szapata8/Ball_beam_control/Deliverables/Project Report - Draft/hardware1.jpg

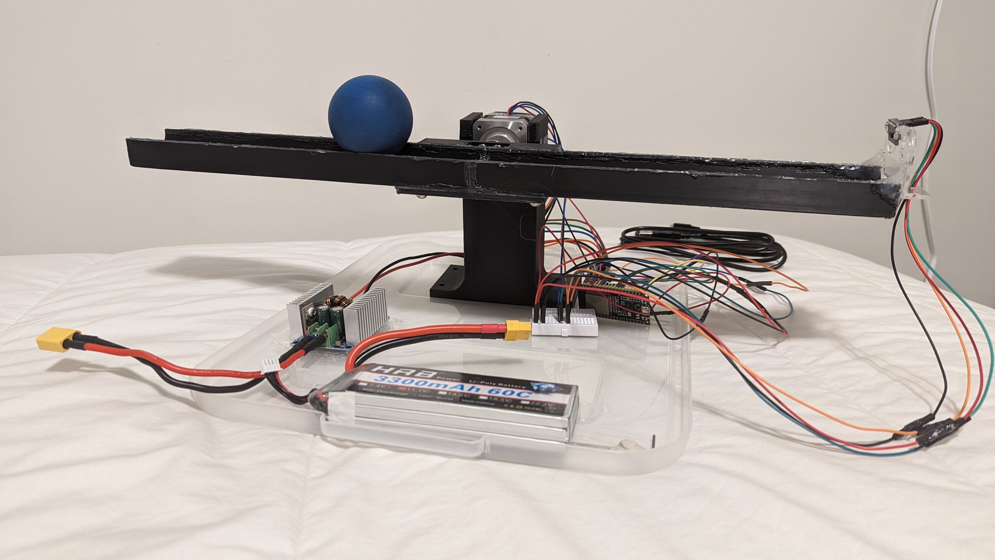
Deliverables/Project Report - Draft/hardware1.jpg
