szapata8/Ball_beam_control/Deliverables/Project Report - Draft/hardware realization.JPG

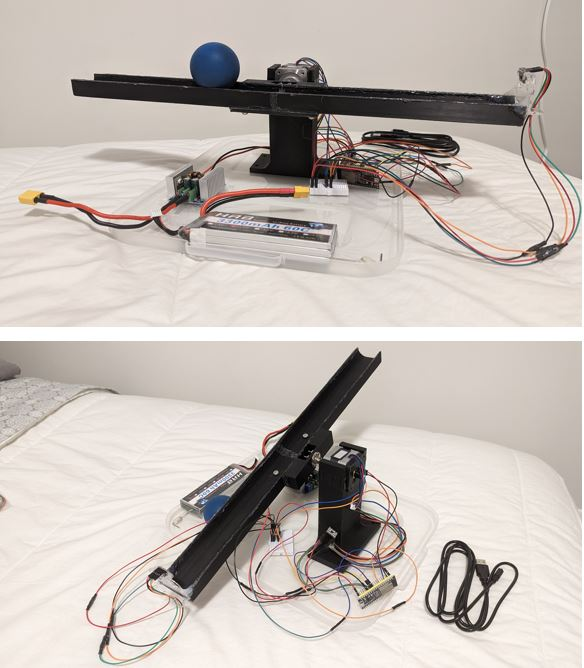
Deliverables/Project Report - Draft/hardware realization.JPG
