szapata8/Ball_beam_control/Deliverables/Project Report - Draft/Ssytem Diagram.pptx

Stepper Motor

Power System

Microcontroller
(ESP32)

Digital Pins

Stepper Motor Driver

Magnetic Encoder

Distance Sensor

Power connections

Web App
(Flask Server)

USB Serial

I2C

I2C

## Slide 2

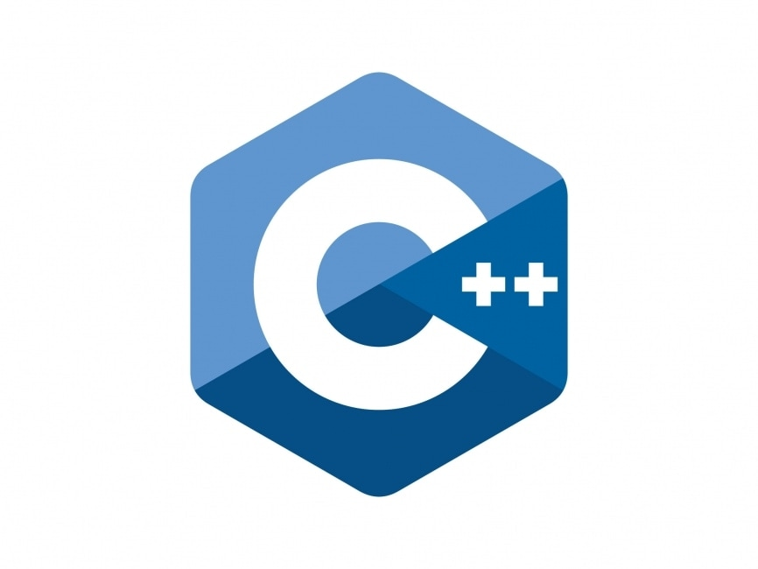
[picture p10: figure]
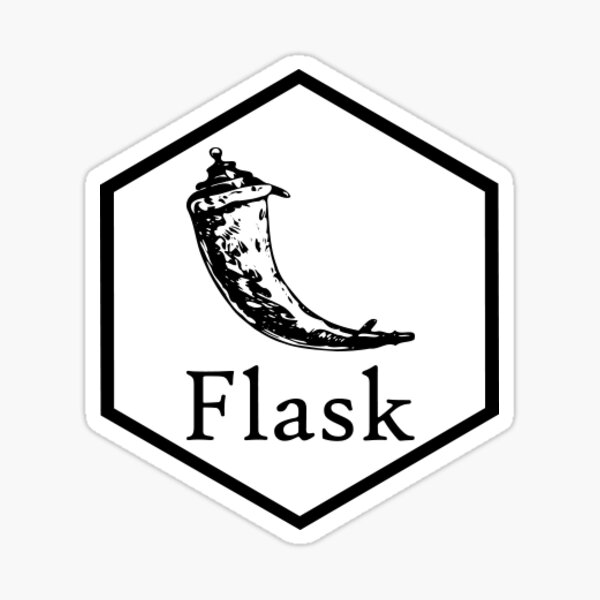
[picture p11: figure]
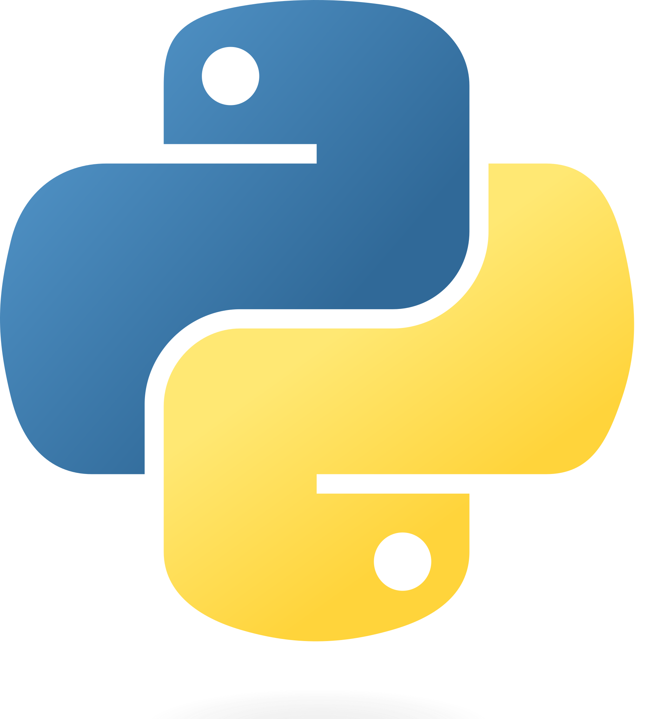
[picture p12: figure]

## Slide 3

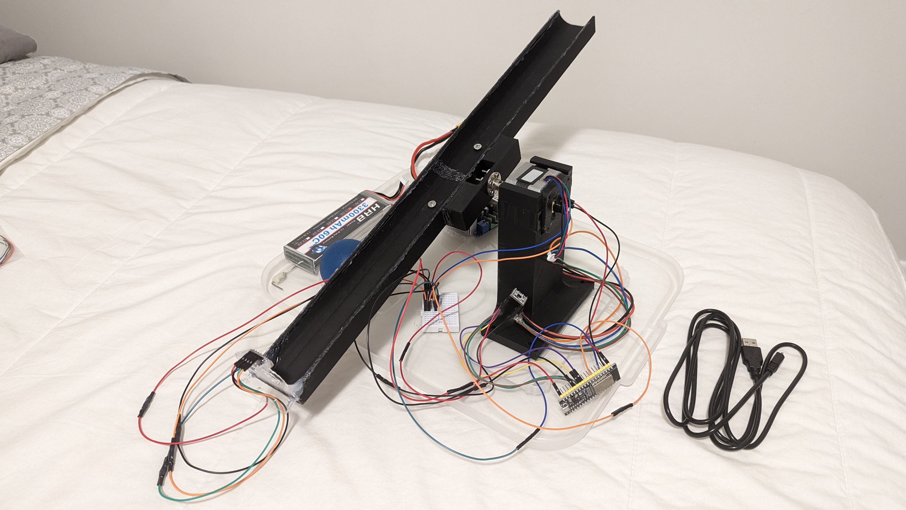
[picture p13: figure]
