szapata8/Ball_beam_control/Deliverables/Project Report - Draft/software_tools.JPG

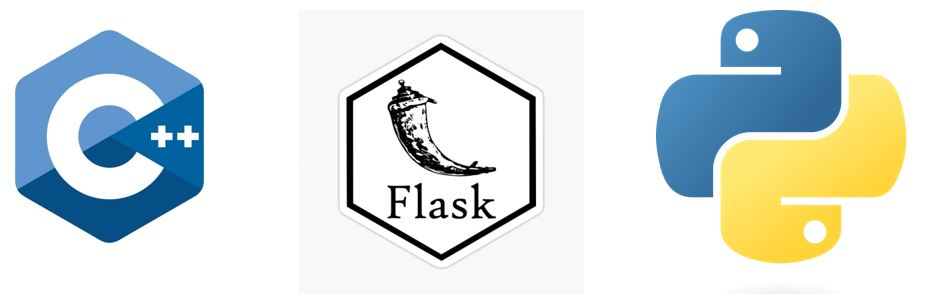
Deliverables/Project Report - Draft/software_tools.JPG
