szapata8/Ball_beam_control/Documentation/DRV8834 Connections.JPG

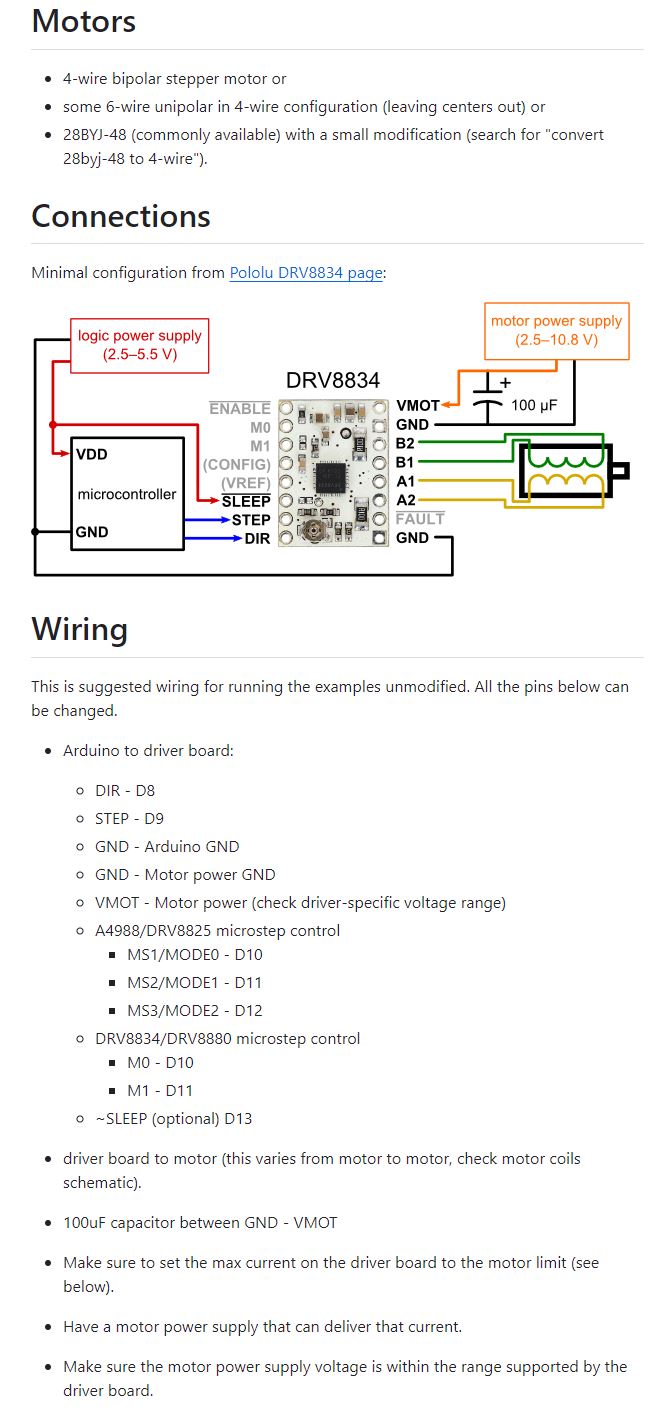
Documentation/DRV8834 Connections.JPG
