szapata8/Ball_beam_control/Documentation/SPECS - HC-SR04 Ultrasonic Distance Sensor.JPG

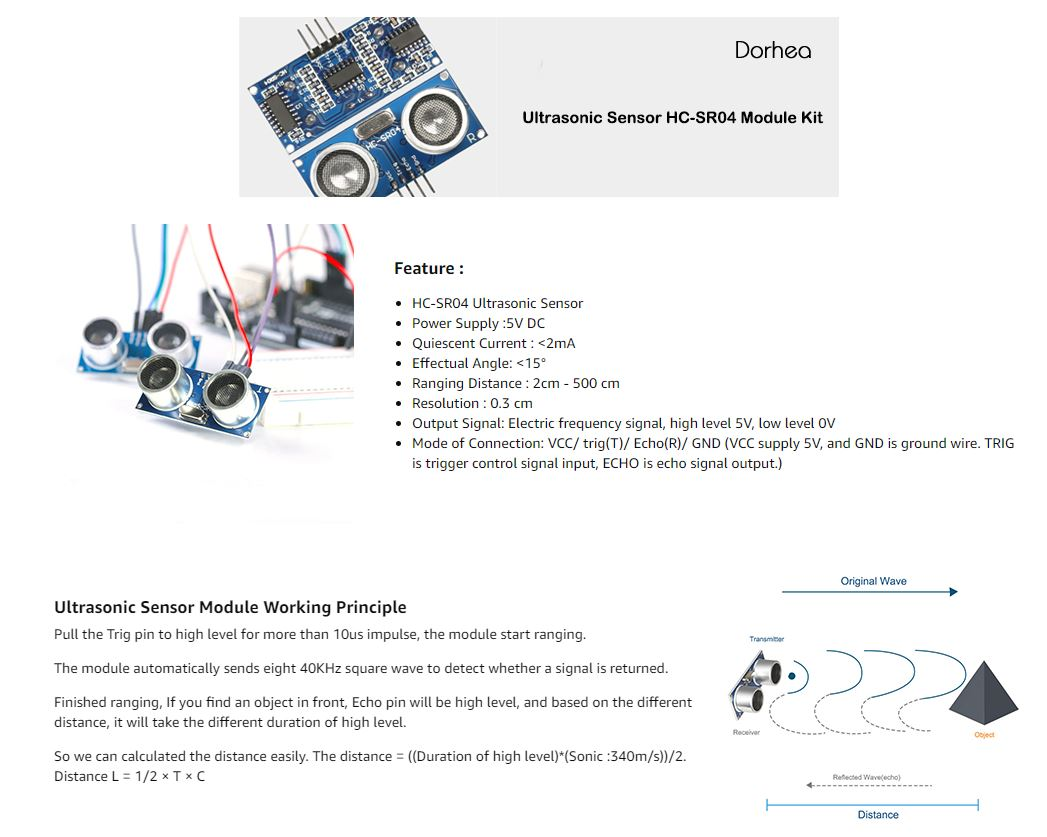
Documentation/SPECS - HC-SR04 Ultrasonic Distance Sensor.JPG
