szapata8/Ball_beam_control/3D Models/platform_wing.stl

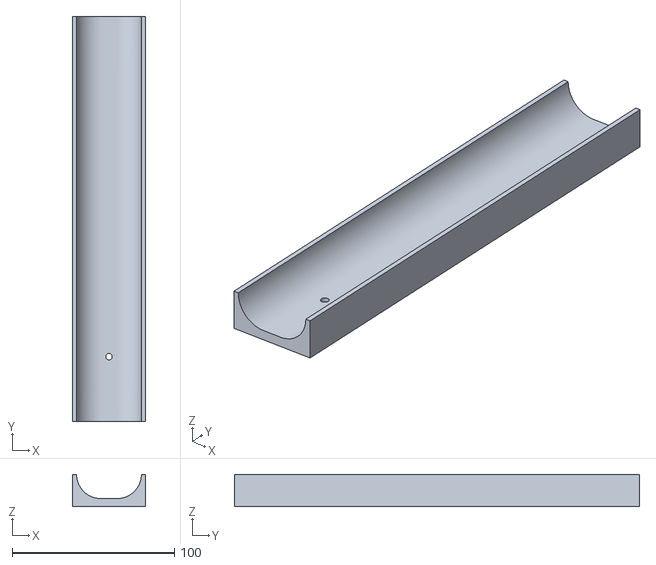
[picture p78: CAD file, 2024-04-23]
3D Models/platform_wing.stl
45.0 x 250.0 x 20.0
