szapata8/Ball_beam_control/3D Models/motor_base.3mf

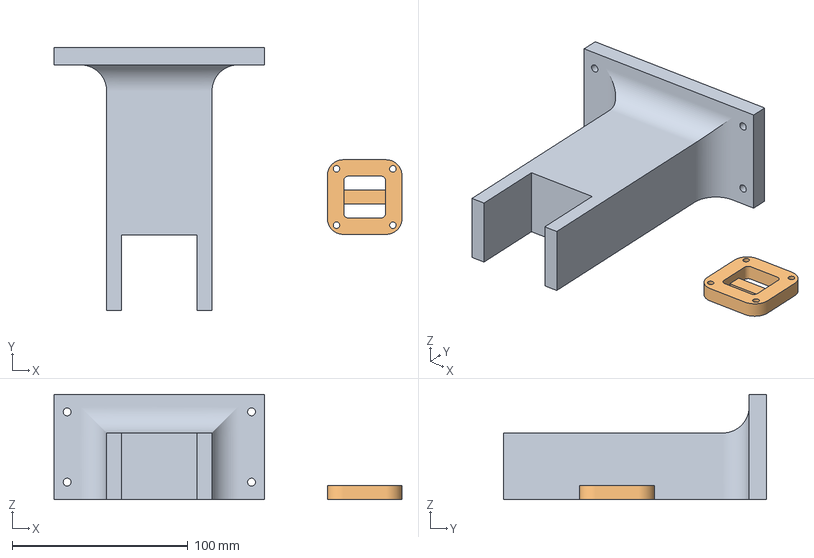
[picture p79: CAD file, 2024-04-23]
3D Models/motor_base.3mf
198.2 x 150.0 x 60.0 mm
motor_base.stl
encoder_housing.stl
