szapata8/Ball_beam_control/3D Models/motor_attachment.3mf

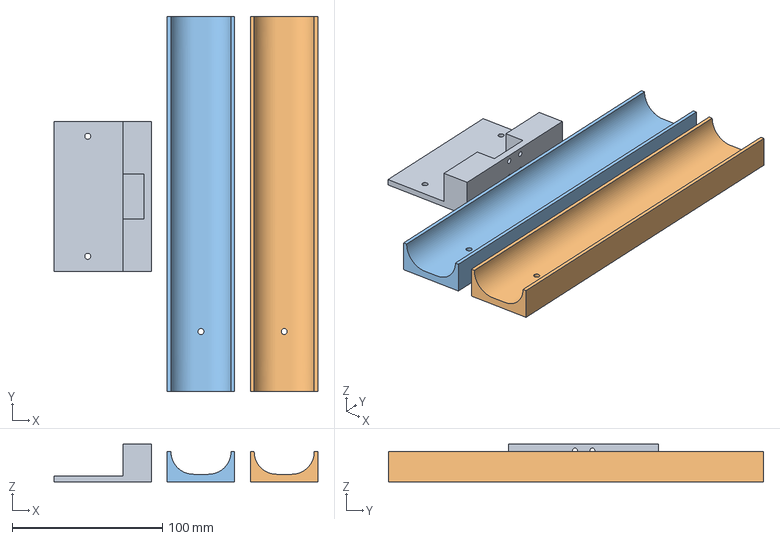
[picture p80: CAD file, 2024-04-23]
3D Models/motor_attachment.3mf
175.9 x 250.1 x 25.0 mm
motor_attachment.stl
platform_wing.stl x 2
