szapata8/Ball_beam_control/3D Models/encoder_housing.stl

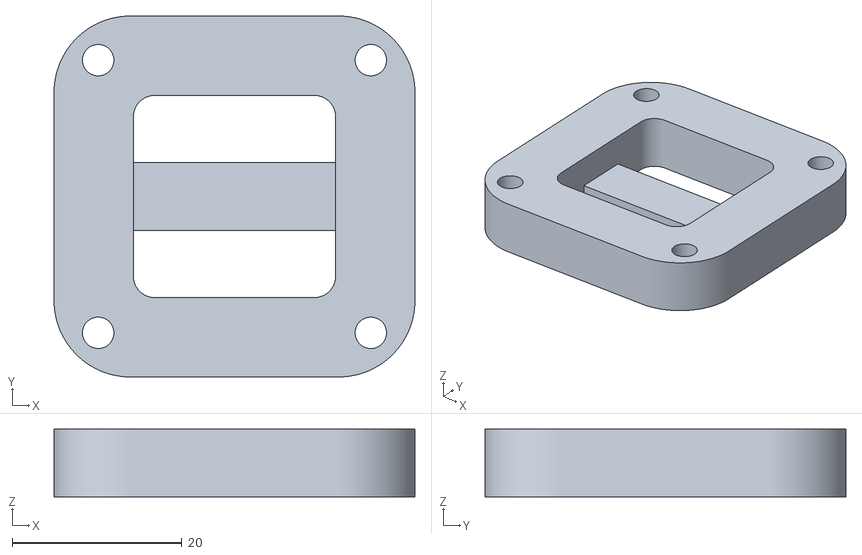
[picture p81: CAD file, 2024-04-23]
3D Models/encoder_housing.stl
42.5 x 42.5 x 8.00
