szapata8/Ball_beam_control/(list of files, cad)

Other CAD files:
3D Models/motor_attachment.stl
3D Models/motor_base.stl
