szapata8/Ball_beam_control/Code/Drivers - unit testing/Distance Sensors/VL53L0X_distance_sensor/error_measurements.xlsx

2.681 | 2.638 | 2.117 | 1.368 | 0.785 | 0.306 | -0.129 | -0.473 | -0.801 | -0.87 | -0.966 | -0.959 | 0.177 | -0.974 | -0.638 | -0.534 | -0.541 | -0.325 | -0.174 | error
25 | 24 | 23 | 22 | 21 | 20 | 19 | 18 | 17 | 16 | 15 | 14 | 13 | 12 | 11 | 10 | 9 | 8 | 7 | actual dist
25 | 26 | 27 | 28 | 29 | 30 | 31 | 32 | 33 | 34 | 35 | 36 | 37 | 38 | 39 | 40 | 41 | 42 | 43 | label dist
22.6 | 20.3 | 18 | 21.5 | 20.1 | 19.3 | 19.7 | 19 | 18.6 | 18.4 | 16.9 | 16.1 | 15 | 12.9 | 13.1 | 11.8 | 10.7 | 9.7 | 8.4
22.8 | 20.5 | 20.9 | 19.1 | 20.9 | 19.3 | 19.3 | 18.5 | 17.3 | 17 | 16 | 14.8 | 12.9 | 12.9 | 11.6 | 10.5 | 9.7 | 7.9 | 6.9
22.4 | 20.4 | 20.6 | 20.5 | 20.1 | 19.6 | 19.8 | 18.4 | 17.8 | 16.8 | 16 | 14.5 | 12.9 | 12.6 | 11.5 | 10.6 | 9.4 | 8.2 | 7.3
21.8 | 21.6 | 20.8 | 20.6 | 20.5 | 20.1 | 19 | 18.6 | 17.9 | 16.8 | 15.7 | 14.5 | 12.4 | 13.3 | 11.6 | 10.1 | 9.4 | 8.6 | 7.2
23 | 21.8 | 21 | 21.4 | 20.4 | 19.4 | 19 | 18.9 | 18.1 | 16.7 | 16 | 15 | 12.6 | 12.8 | 11.7 | 10.4 | 9.4 | 8.4 | 6.7
22.5 | 22 | 20.5 | 20.1 | 20.2 | 19.2 | 19 | 18.4 | 17.4 | 17.4 | 15.7 | 14.9 | 12.7 | 13.1 | 11.9 | 10.5 | 9.5 | 8.4 | 7
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
