szapata8/Ball_beam_control/Code/Drivers - unit testing/Distance Sensors/HC-SR04_distance_sensor/src/main.cpp

#include <Arduino.h>
#include <HCSR04.h>

byte triggerPin = 14;
byte echoPin = 27;

void setup () {
  Serial.begin(9600);
  HCSR04.begin(triggerPin, echoPin);
}

void loop () {
  double* distances = HCSR04.measureDistanceCm();
  
  Serial.print("1: ");
  Serial.print(distances[0]);
  Serial.println(" cm");
  
  Serial.println("---");
  delay(100);
}
